TaaraLabs/RS485-CANbus-DCDC-WeMos/RS485-CANbus-DCDC-WeMos-PCB.jpg

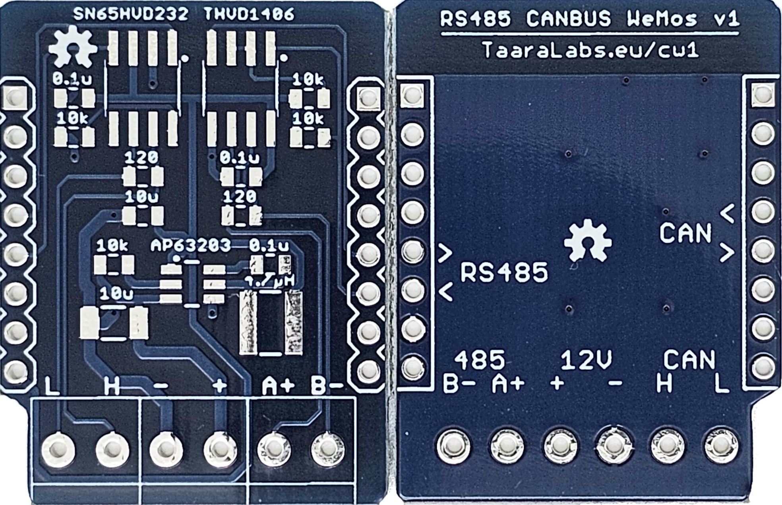
RS485-CANbus-DCDC-WeMos-PCB.jpg
