TaaraLabs/RS485-CANbus-DCDC-WeMos/image-1.png

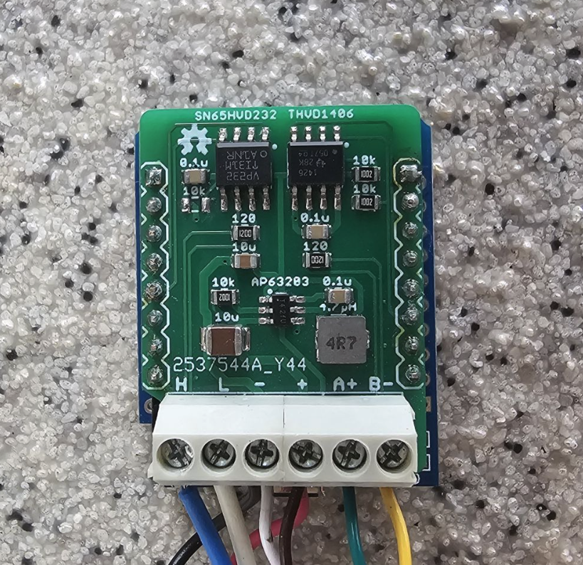
image-1.png
