TaaraLabs/RS485-CANbus-DCDC-WeMos/README.md

RS485-CanBus-WeMos
==================

RS-485+CanBus+DCDC Converter Shield for WeMos D1 Mini32

[Official WebSite](https://taaralabs.eu/cw1)
