TaaraLabs/RS485-CANbus-DCDC-WeMos/image-2.png

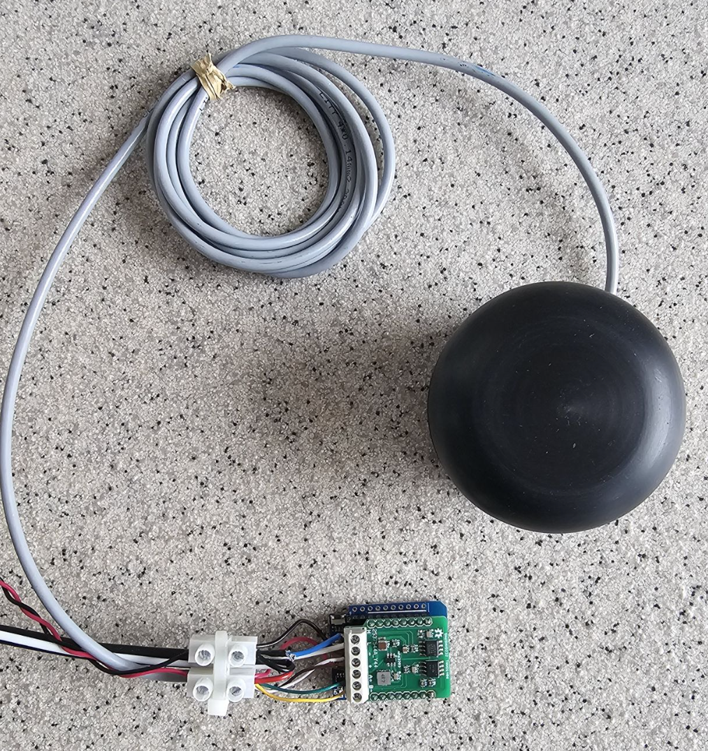
image-2.png
