TaaraLabs/RS485-CANbus-DCDC-WeMos/RS485-CANbus-DCDC-WeMos.jpg

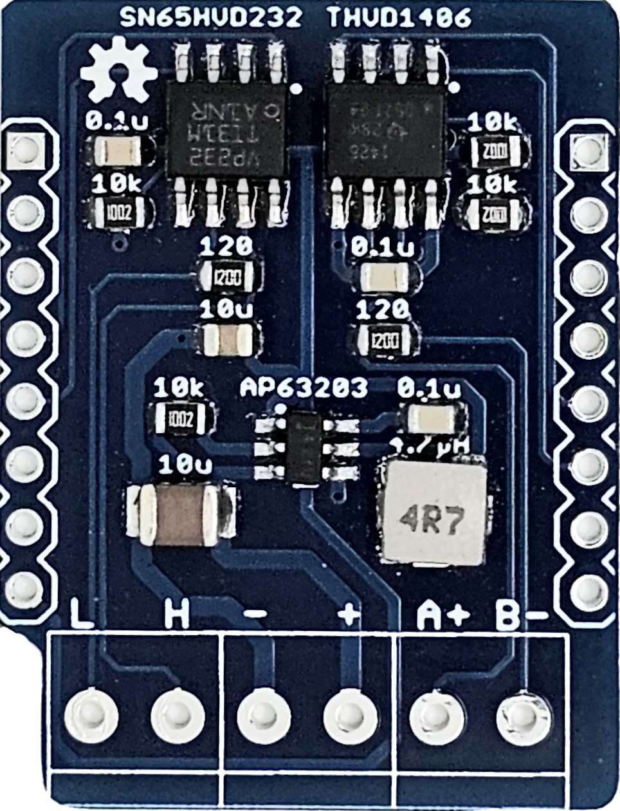
RS485-CANbus-DCDC-WeMos.jpg
