TaaraLabs/RS485-CANbus-DCDC-WeMos/RS485-CANBUS-WeMos-brd.png

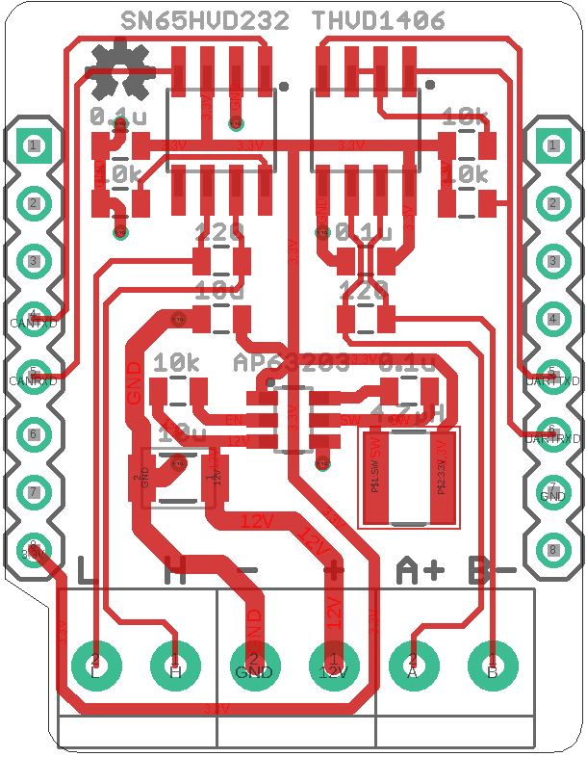
RS485-CANBUS-WeMos-brd.png
