TaaraLabs/RS485-CANbus-DCDC-WeMos/RS485-CANBUS-WeMos-sch.png

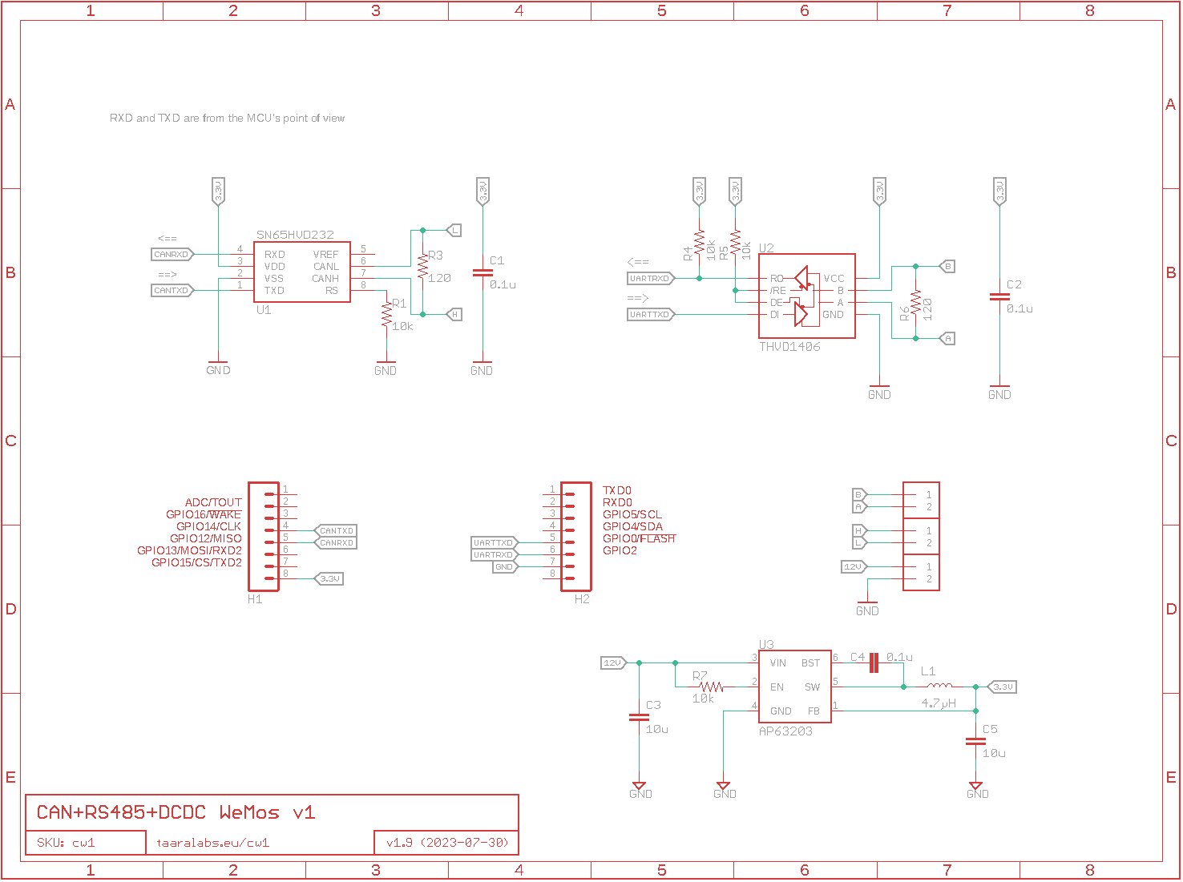
RS485-CANBUS-WeMos-sch.png
