TaaraLabs/RS485-CANbus-DCDC-WeMos/RS485-CANBUS-WeMos.brd

## EAGLE design RS485-CANBUS-WeMos.brd (2023-07-31)

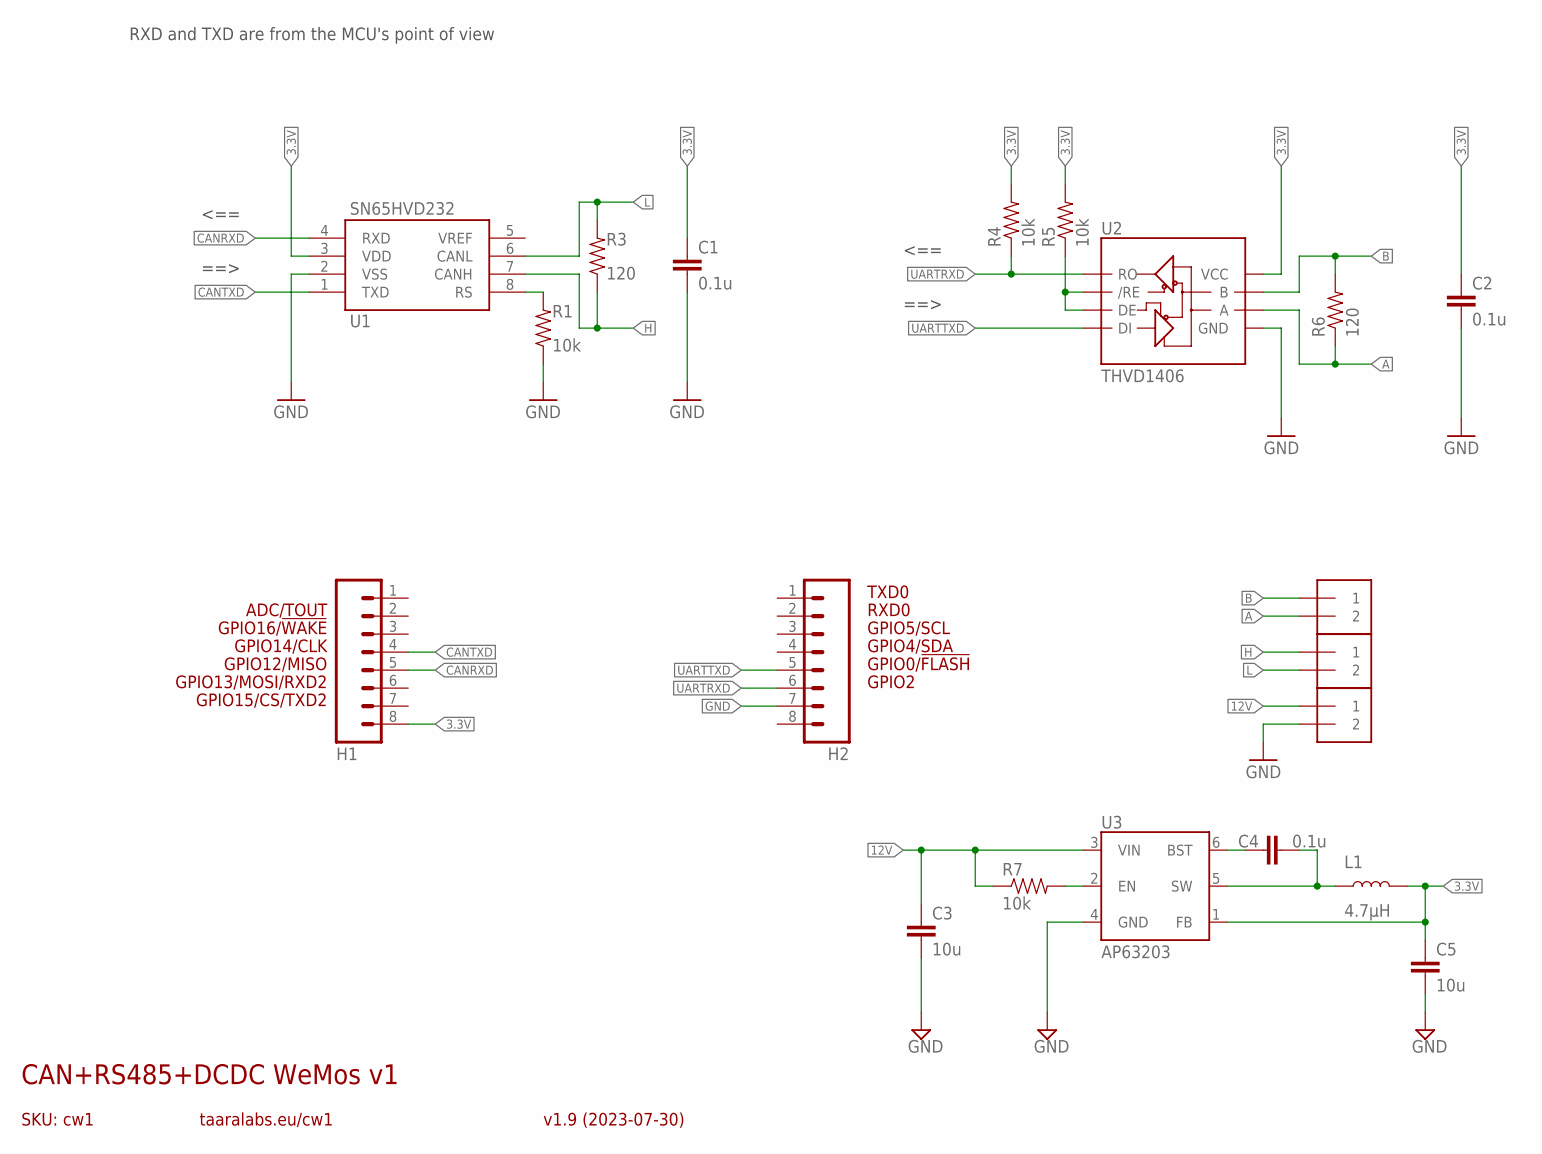
[picture p7: schematic RS485-CANBUS-WeMos.sch]

Parts:
C1, C2, C4: 0.1u; 0805
C3: 10u; 1210
C5: 10u; 0805
H1, H2: M08; 1X08
J1, J2, J3: 1X2-3.5MM
L1: 4.7μH; INDUCTOR_4X4MM
R1, R4, R5, R7: 10k; 0805
R3, R6: 120; 0805
U1: SN65HVD232; SO08
U2: THVD1406; SO08
U3: AP63203; SOT23-6

Connections:
3.3V: C1.1, C2.1, C5.1, H1.8, L1.P$2 (2), R4.2, R5.2, U1.3 (VDD), U2.8 (VCC), U3.1 (FB)
12V: C3.1, J2.1, R7.1, U3.3 (VIN)
/SHDN: R5.1, U2.2 (/RE), U2.3 (DE)
A: J3.2, R6.1, U2.6 (A)
B: J3.1, R6.2, U2.7 (B)
BST: C4.1, U3.6 (BST)
CANRXD: H1.5, U1.4 (RXD)
CANTXD: H1.4, U1.1 (TXD)
EN: R7.2, U3.2 (EN)
GND: C1.2, C2.2, C3.2, C5.2, H2.7, J2.2, R1.1, U1.2 (VSS), U2.5 (GND), U3.4 (GND)
H: J1.1, R3.1, U1.7 (CANH)
L: J1.2, R3.2, U1.6 (CANL)
RS: R1.2, U1.8 (RS)
SW: C4.2, L1.P$1 (1), U3.5 (SW)
UARTRXD: H2.6, R4.1, U2.1 (RO)
UARTTXD: H2.5, U2.4 (DI)

Notes on the sheet:
GPIO2
GPIO0/!FLASH
GPIO12/MISO
GPIO4/SDA
GPIO5/SCL
RXD0
TXD0
GPIO13/MOSI/RXD2
GPIO14/CLK
GPIO15/CS/TXD2
GPIO16/!WAKE
SKU: cw1
CAN+RS485+DCDC WeMos v1
v1.9 (2023-07-30)
taaralabs.eu/cw1
ADC/TOUT
<==
==>
RXD and TXD are from the MCU's point of view

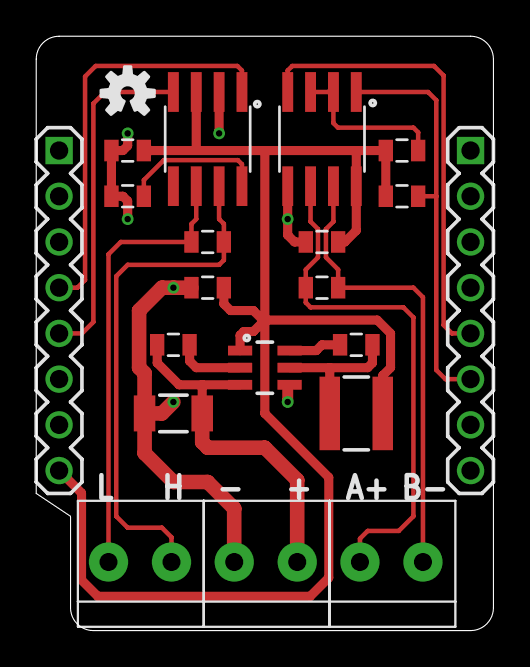
[picture p8: board RS485-CANBUS-WeMos.brd from above]

Board: 2 copper layers, 25.4 x 33.0 mm, 22 parts (1 on the bottom side), 16 nets.

Other parts of the board:
U$1, U$2: OSHW-LOGO-S
