TaaraLabs/RS485-CANbus-DCDC-WeMos/(commit log)

2023-07-31 New revision
    [RS485-CANBUS-WeMos.brd, RS485-CANBUS-WeMos.sch]
2023-07-31 WeMos ESP32 D1 Mini pinout
2025-03-12 Board definitions for ESP32-NMEA2000
2025-03-12 ESP32C3 not compiling
2025-03-13 CAN and RS485 Serial working on ESP32C3 without USB
2025-03-13 disclaimer about ESP32C3
